UChicago-Space-Program/instrumentation/hasp-balloon/hasp_balloon_code/hasp/hasp_lib/716.jpg

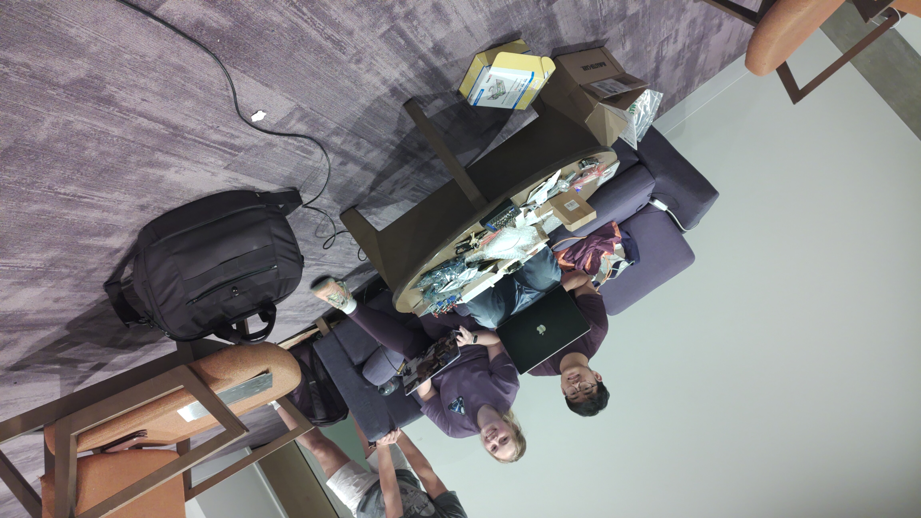
hasp-balloon/hasp_balloon_code/hasp/hasp_lib/716.jpg
