UChicago-Space-Program/instrumentation/hasp-balloon/hasp_balloon_code/hasp/hasp_lib/fast.jpg

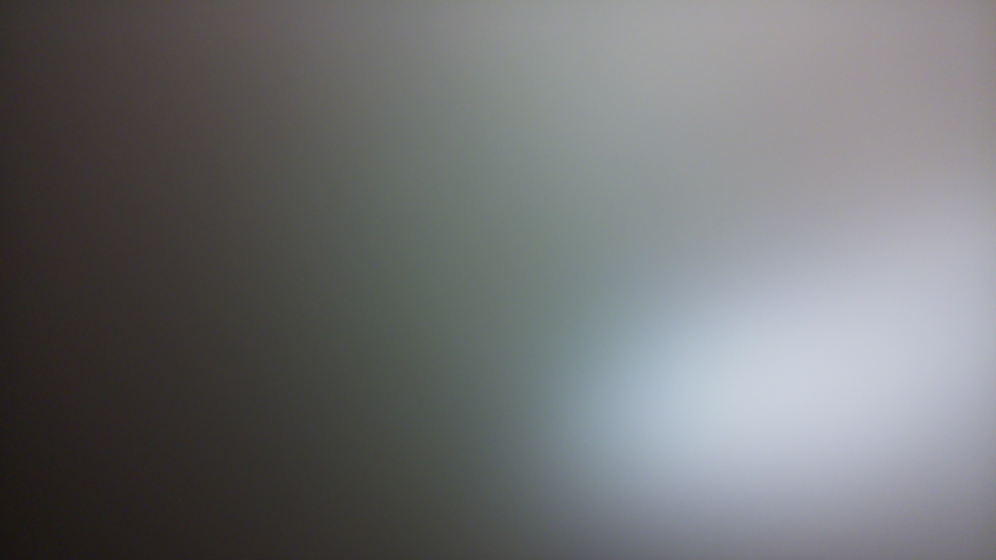
hasp-balloon/hasp_balloon_code/hasp/hasp_lib/fast.jpg
