UChicago-Space-Program/instrumentation/hasp-balloon/hasp_balloon_code/hasp/fast.jpg

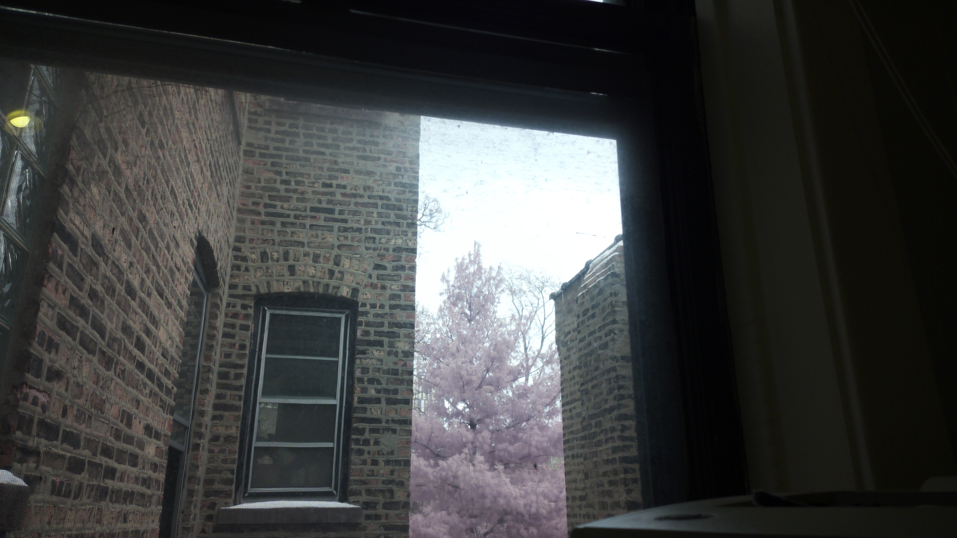
hasp-balloon/hasp_balloon_code/hasp/fast.jpg
