UChicago-Space-Program/instrumentation/hasp-balloon/hasp_balloon_code/hasp/pic0.jpg

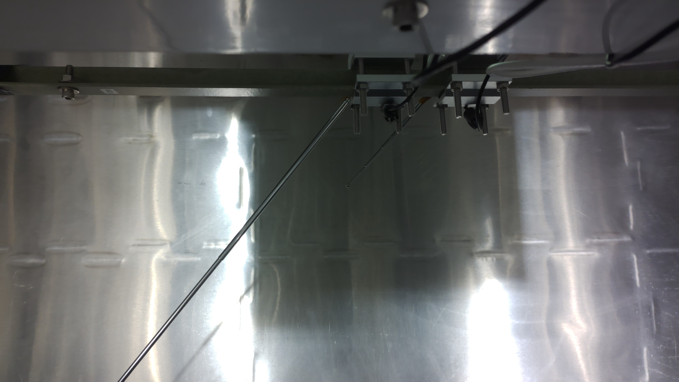
hasp-balloon/hasp_balloon_code/hasp/pic0.jpg
