UChicago-Space-Program/instrumentation/hasp-balloon/hasp_balloon_code/hasp/test1.csv

timestamp | Thermistors | Thermocouple 1 | Thermocouple 2 | RTD | BMP | Pump 1 | Pump 2
2026-04-20 17:02:36.731 | [1.521116960402838, 1.7531517509727625, 2.0367498283360037, 2.410583657587549, 2.5781643396658276, 2.565273517967498, 2.3848020141908903, 2.178548867017624] | 0.0 | 0.0 | -242.02 | hi | 0 | 0
2026-04-20 17:02:38.820 | [2.2301121538109405, 2.410583657587549, 2.5008194094758522, 2.3976928358892193, 2.5394918745708397, 2.5137102311741817, 2.410583657587549, 2.475037766079194] | 0.0 | 0.0 | -242.02 | hi | 0 | 0
2026-04-20 17:02:40.909 | [2.2816754406042574, 2.255893797207599, 2.5266010528725107, 2.436365300984207, 2.6168368047608146, 2.668400091554131, 2.758635843442435, 2.6168368047608146] | 0.0 | 0.0 | -242.02 | hi | 0 | 0
2026-04-20 17:02:42.998 | [2.603945983062485, 2.603945983062485, 2.6168368047608146, 2.655509269855802, 2.758635843442435, 2.668400091554131, 2.7844174868390934, 2.6812909132524605] | 0.0 | 0.0 | -242.02 | hi | 0 | 0
2026-04-20 17:02:45.092 | [2.4492561226825362, 2.655509269855802, 2.745745021744106, 2.6297276264591436, 2.707072556649119, 2.552382696269169, 2.5266010528725107, 2.4492561226825362] | 0.0 | 0.0 | -242.02 | hi | 0 | 0
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
