UChicago-Space-Program/instrumentation/hasp-balloon/electronics/logic/PASCAL_logic_11_4_26.pdf

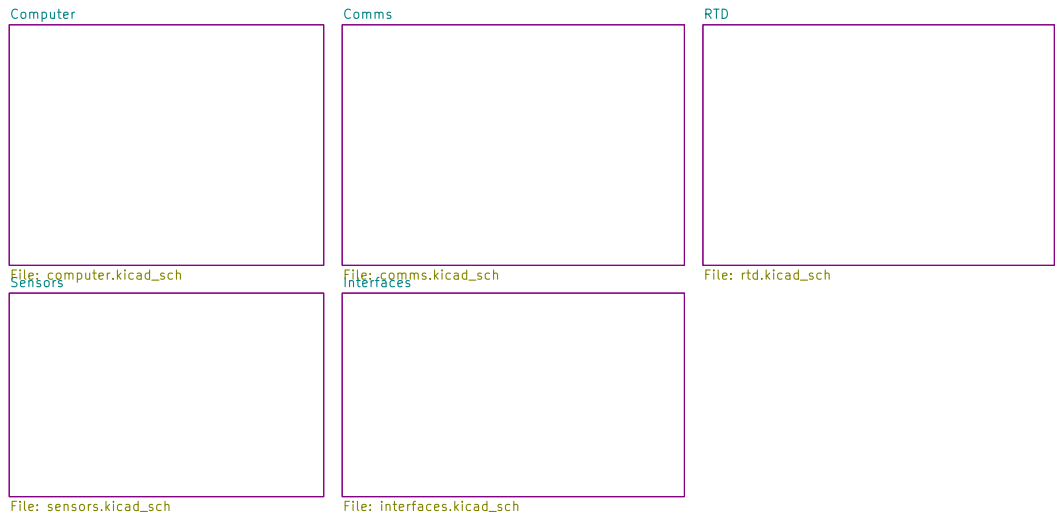
[picture p33: page 1]

Size: A4 | Rev:
KiCad E.D.A. 10.0.8 | Id: 1/6

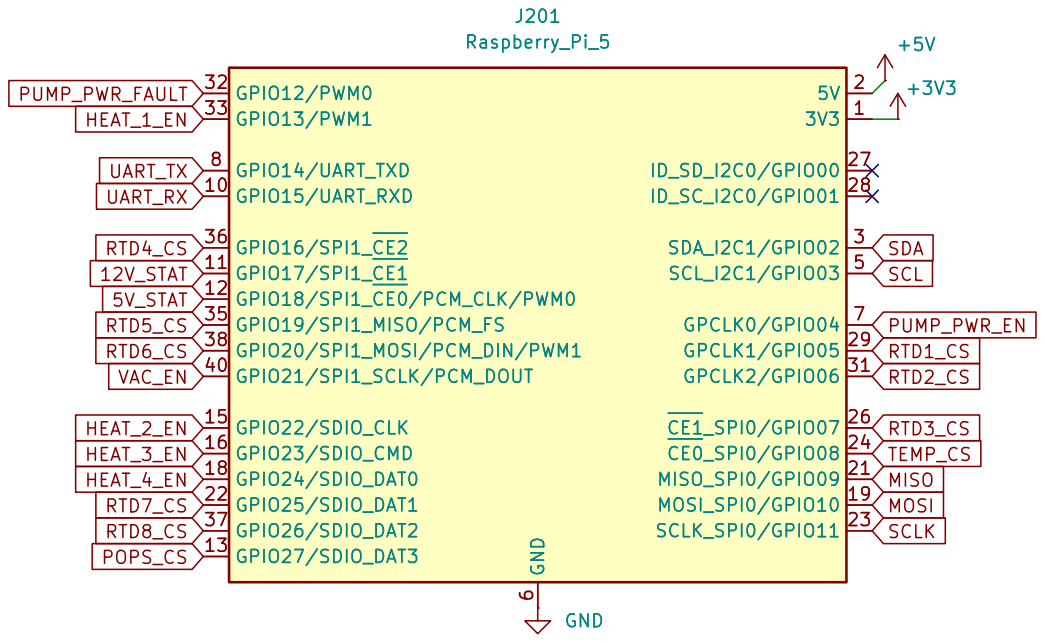
[picture p34: page 2]

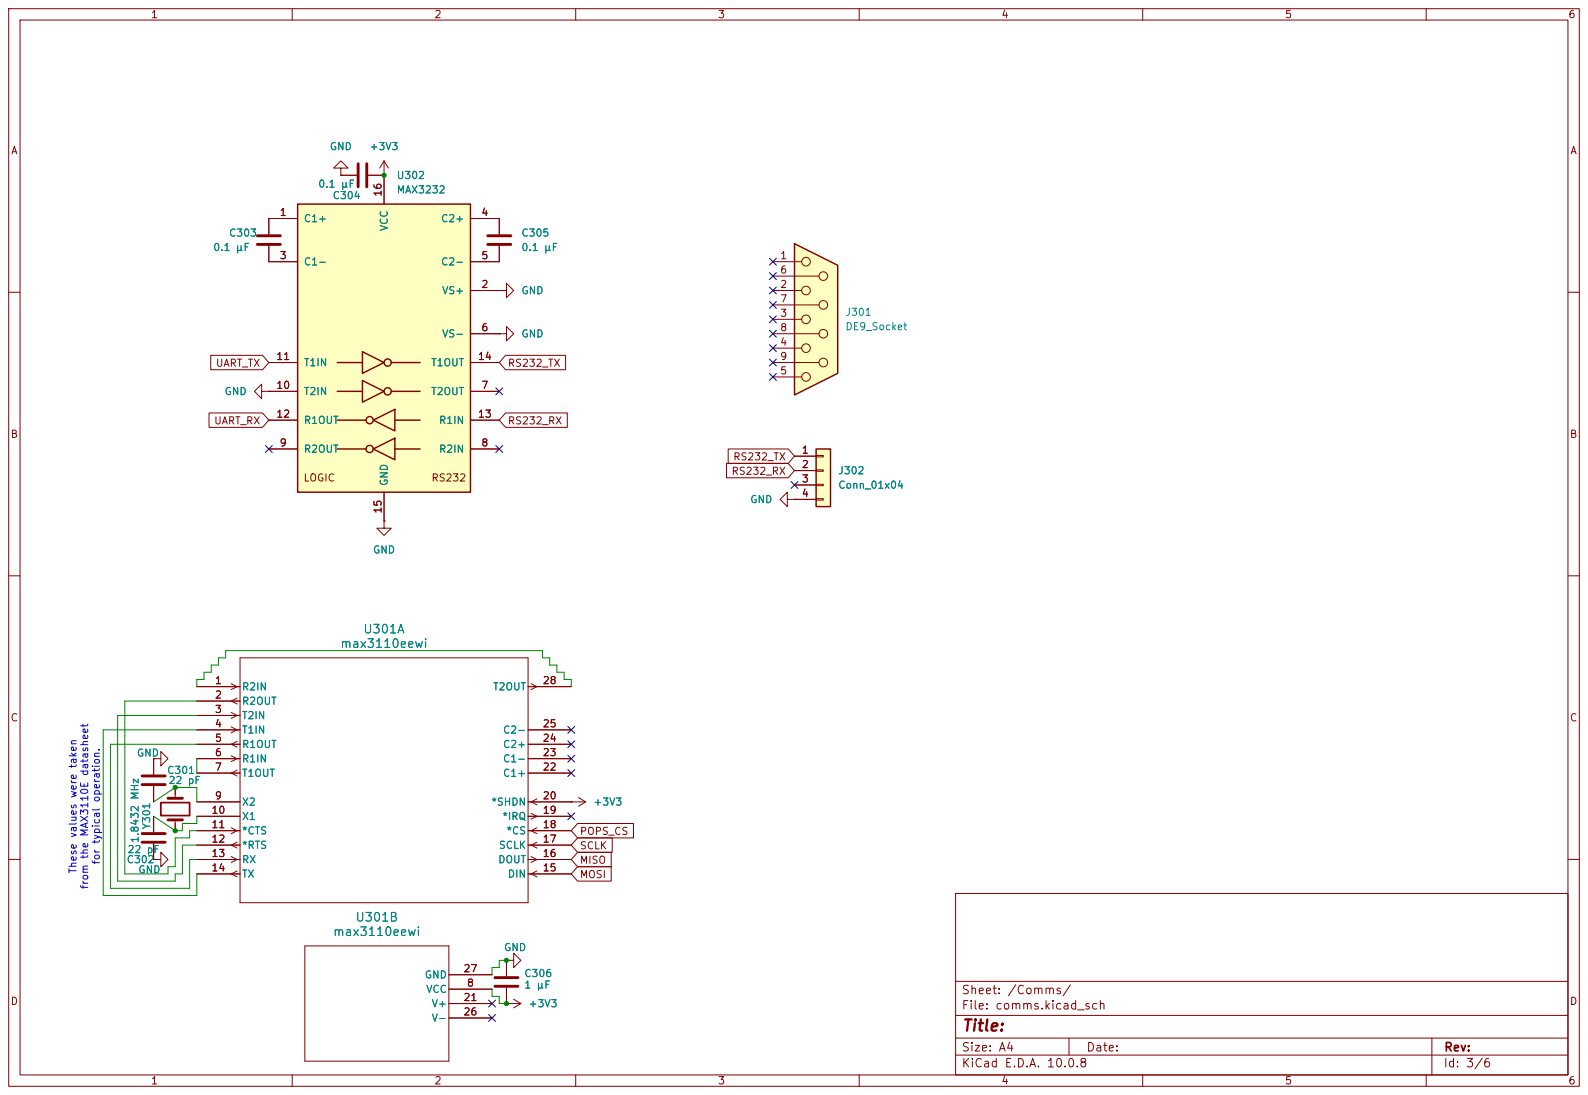
[picture p35: page 3]

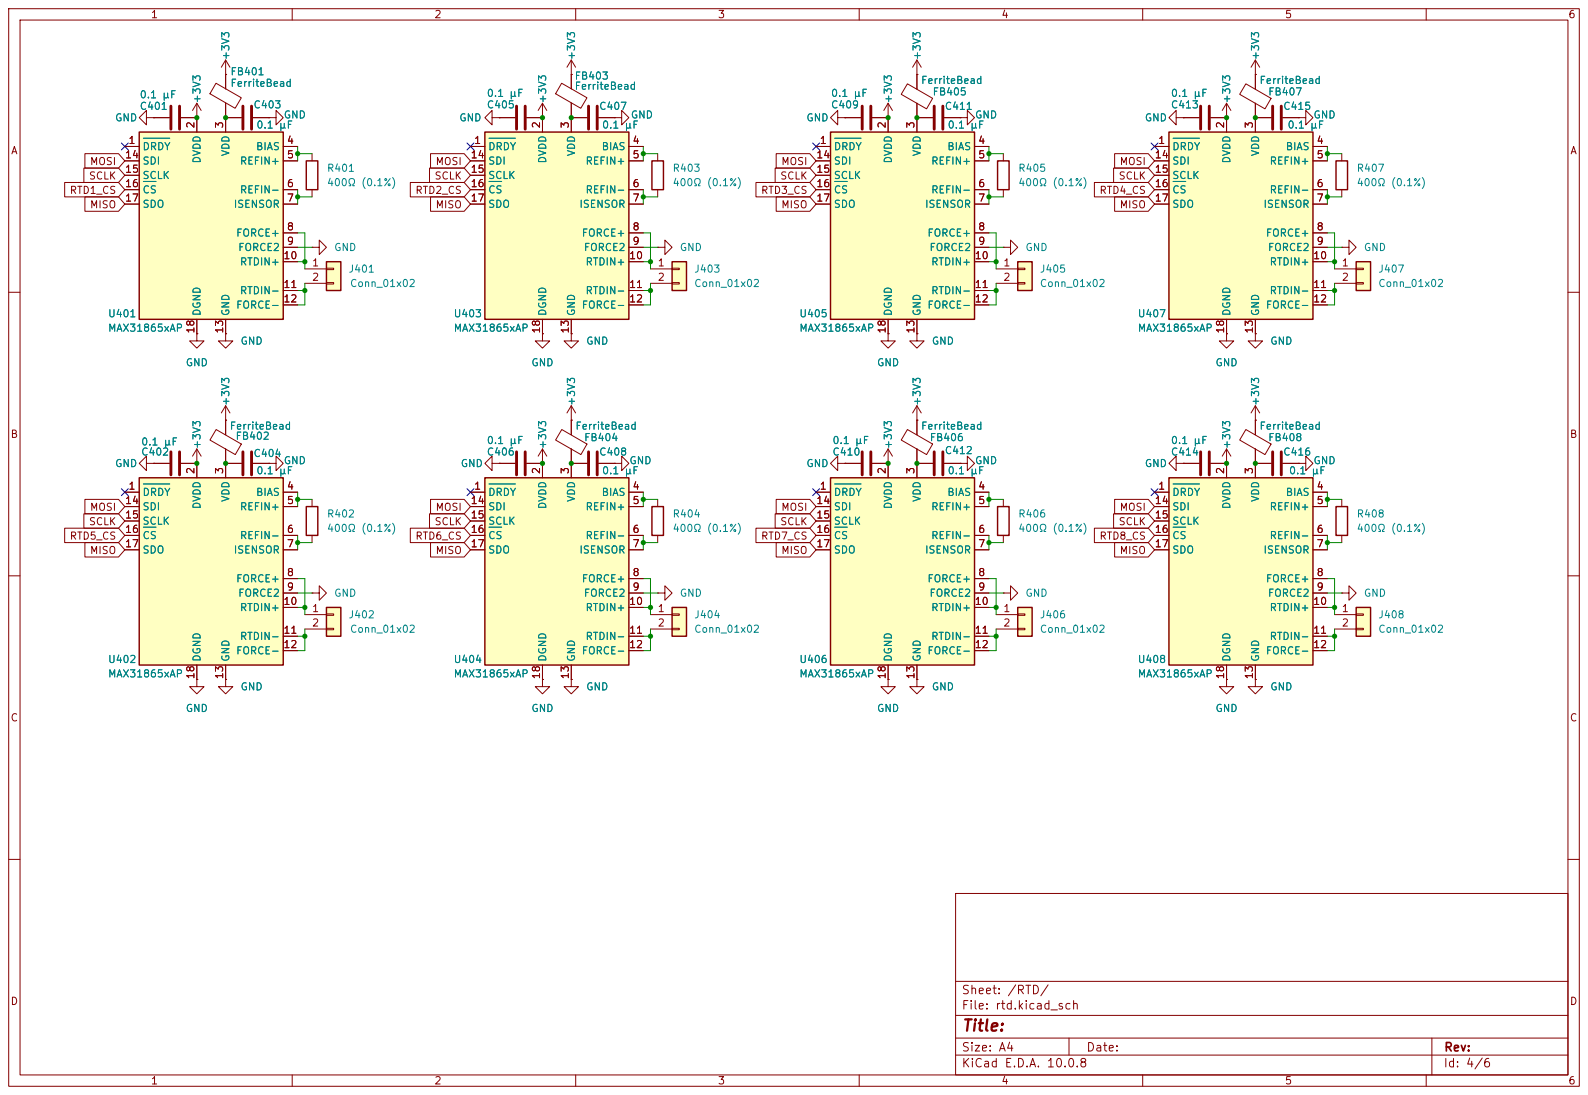
[picture p36: page 4]

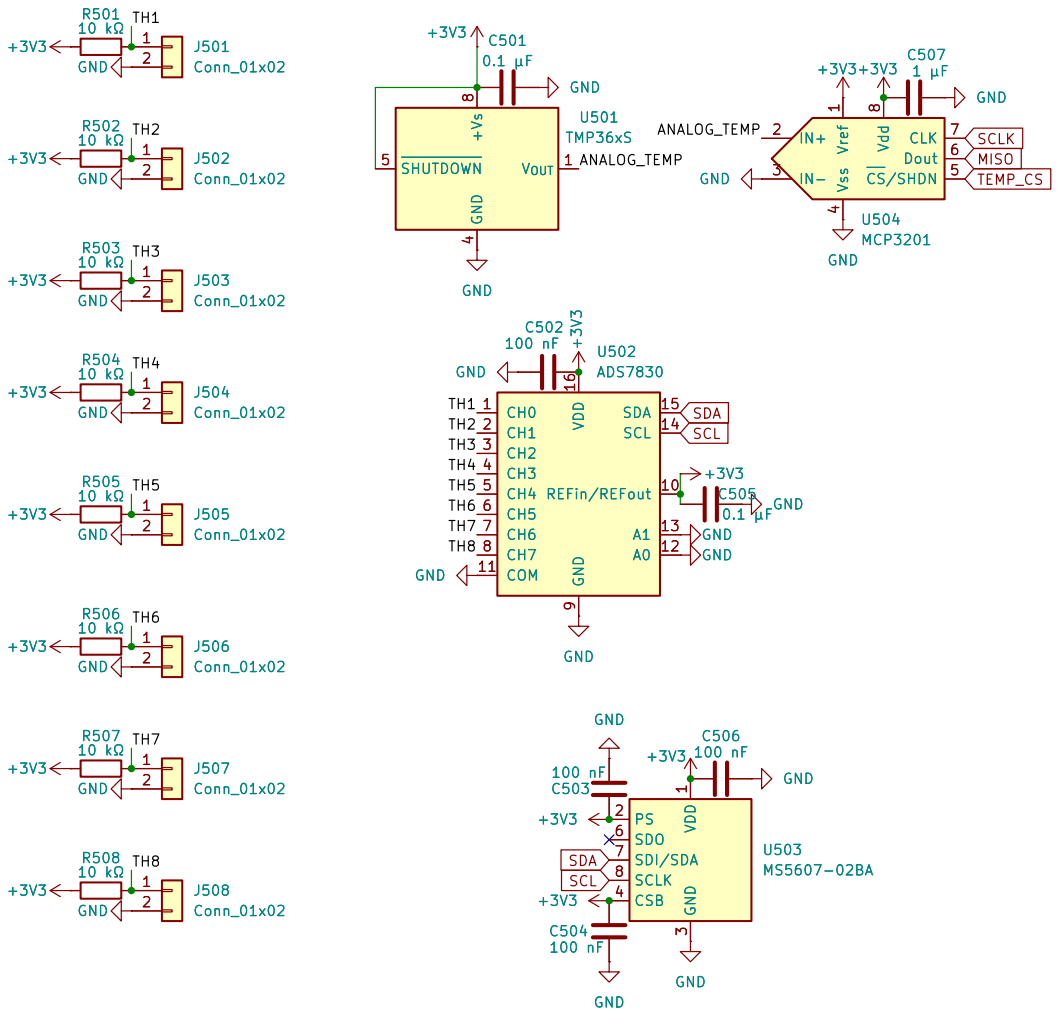
[picture p37: page 5]

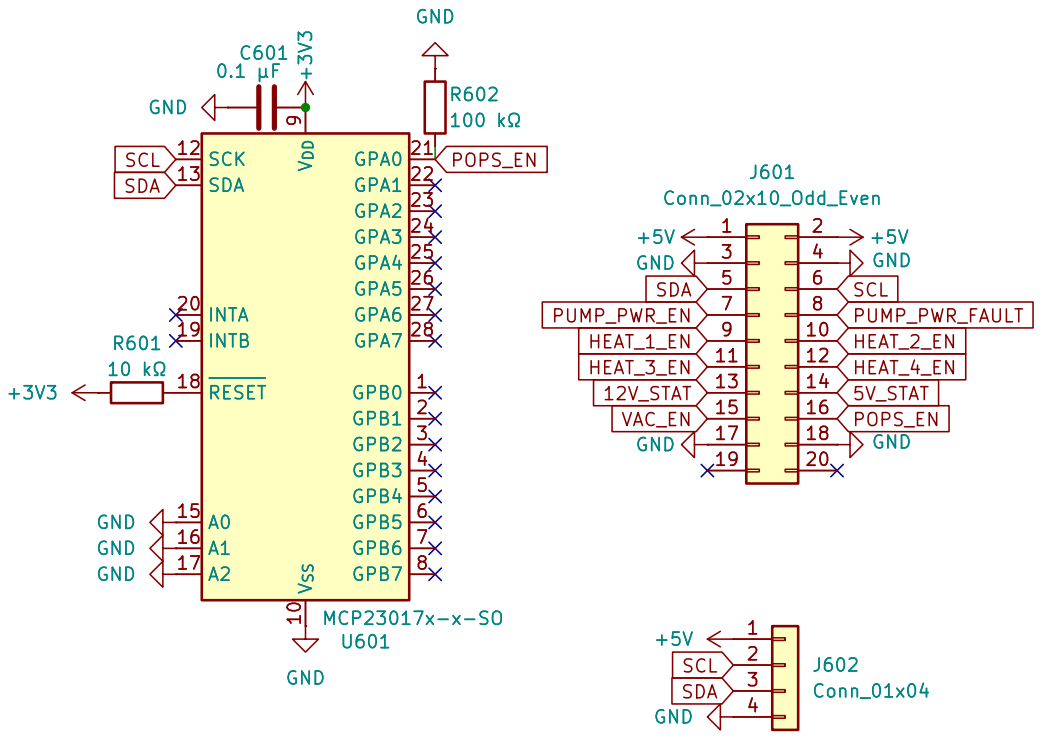
[picture p38: page 6]
