UChicago-Space-Program/instrumentation/hasp-balloon/electronics/power/power.kicad_pcb

## KiCad design hasp-balloon/electronics/power/power.kicad_pcb (2025-11-04)

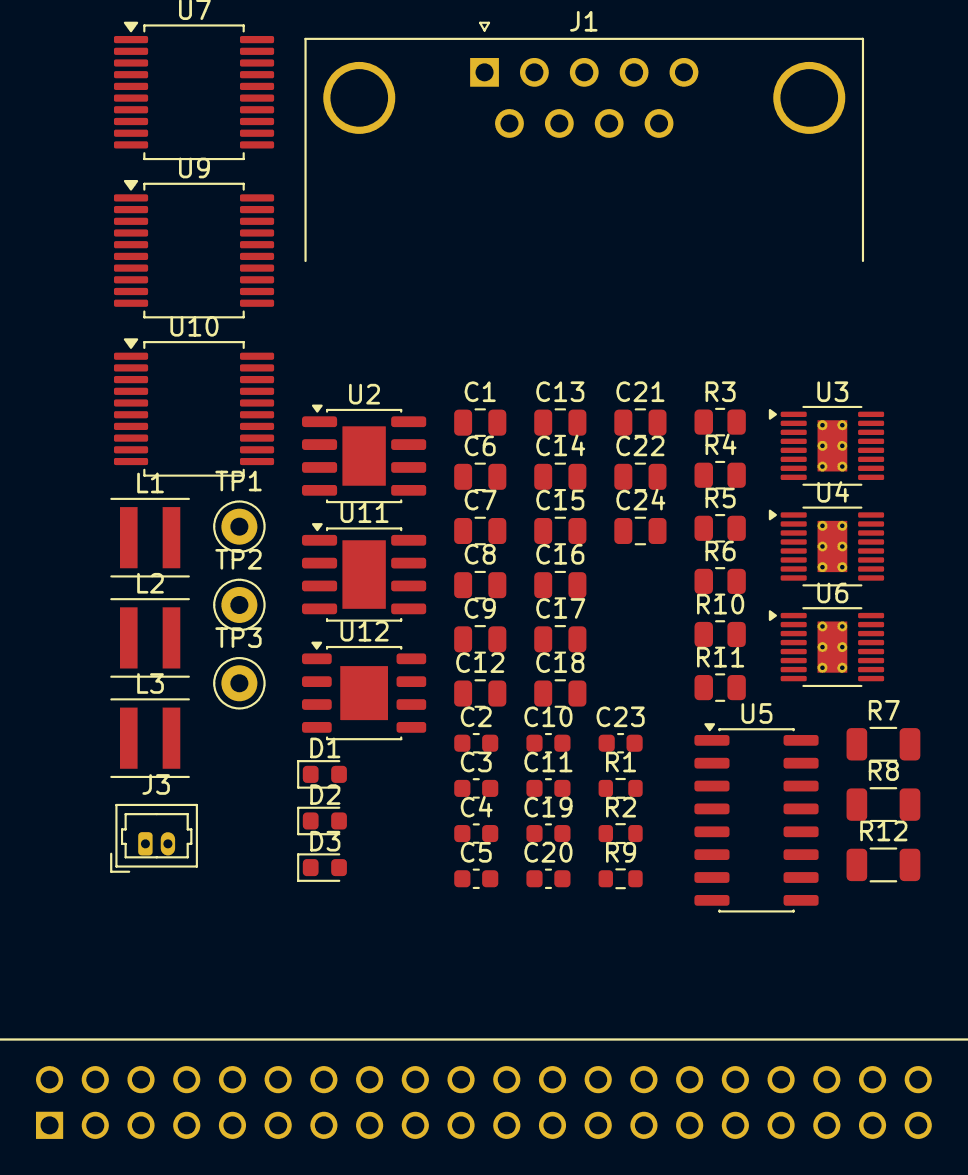
[picture p39: board power.kicad_pcb from above]

Board: 2 copper layers, 58 parts (0 on the bottom side), 44 nets, no tracks yet.

Parts:
C1, C8, C9, C14, C15, C16, C17, C18, C22: 0.1uF; C_0805_2012Metric
C2, C3, C19: 10nF; C_0603_1608Metric
C4, C5, C20: 4.7uF; C_0603_1608Metric
C6, C7, C21: 10pF; C_0805_2012Metric
C10, C11, C23: 1uF; C_0603_1608Metric
C12, C13, C24: 68uF; C_0805_2012Metric
D1, D2, D3: 150060VS75000; LED_0603_1608Metric
J1: DB9; DSUB-9_Pins_Horizontal_P2.77x2.84mm_EdgePinOffset7.70mm_Hou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
J3: Screw Terminal 1x2; Molex_PicoBlade_53047-0210_1x02_P1.25mm_Vertical
L1, L2, L3: 10uH; L_Coilcraft_XxL4040
R1, R2, R9: 110k; R_0603_1608Metric
R3, R4, R10: 243k; R_0805_2012Metric
R5, R6, R11: 1M; R_0805_2012Metric
R7, R8, R12: 150; C_1206_3216Metric
TP1, TP2, TP3: TestPoint_Keystone_5000-5004_Miniature
U1: RASPBERRY_PI_ZERO_2_W; MODULE_RASPBERRY_PI_ZERO_2_W
U2: TMP36FSZ; SOIC-8-1EP_3.9x4.9mm_P1.27mm_EP2.41x3.3mm
U3, U4, U6: LT8610; MSOP-16-1EP_3x4.039mm_P0.5mm_EP1.651x2.845mm_ThermalVias
U5: MAX3232; SOIC-16_3.9x9.9mm_P1.27mm
U7, U9, U10: MAX31865xAP; SSOP-20_5.3x7.2mm_P0.65mm
U11: MCP3201; SOIC-8-1EP_3.9x4.9mm_P1.27mm_EP2.41x3.81mm
U12: BSP742T; Infineon_PG-DSO-8-27_3.9x4.9mm_EP2.65x3mm

Connections:
3V3: C1.2, C14.2, U1.1 (3V3_1), U1.17 (3V3_17), U2.5 (SHUTDOWN), U2.8 (V_IN), U5.16 (VCC)
5V: C6.2, C12.2, D1.2 (A), L1.2, R5.2, TP1.1, U1.2 (5V_2), U1.4 (5V_4), U3.14 (BIAS)
5V_STAT: U3.15 (PG), U4.15 (PG), U6.15 (PG)
6V: C7.2, C13.2, D2.2 (A), L2.2, R6.2, TP2.1, U4.14 (BIAS)
12V: C21.2, C24.2, D3.2 (A), L3.2, R11.2, TP3.1, U6.14 (BIAS), U12.5 (Vbb), U12.6 (Vbb), U12.7 (Vbb), U12.8 (Vbb)
28V: C4.1, U3.4 (EN/UV), U3.5 (VIN), U3.6 (VIN)
/FB_3: C6.1, C7.1, C21.1, R3.2, R4.2, R5.1, R6.1, R10.2, R11.1, U3.16 (FB), U4.16 (FB), U6.16 (FB)
/MISO: U1.21 (GPIO9/SPI_MISO), U7.17 (SDO), U9.17 (SDO), U10.17 (SDO)
/MOSI: U1.19 (GPIO10/SPI_MOSI), U7.14 (SDI), U9.14 (SDI), U10.14 (SDI)
/RS232_RX: J1.3, U5.13 (R1IN)
/RS232_TX: J1.2, U5.14 (T1OUT)
/SCLK: U1.23 (GPIO11/SPI_SCLK), U7.15 (SCLK), U9.15 (SCLK), U10.15 (SCLK)
/SW_3: C8.2, C9.2, C22.2, L1.1, L2.1, L3.1, U3.9 (SW), U3.10 (SW), U3.11 (SW), U4.9 (SW), U4.10 (SW), U4.11 (SW), U6.9 (SW), U6.10 (SW), U6.11 (SW)
/UART_RX: U1.10 (GPIO15/RXD0), U5.12 (R1OUT)
/UART_TX: U1.8 (GPIO14/TXD0), U5.11 (T1IN)
/VAC_EN: U1.40 (GPIO21), U12.2 (IN)
GND: C1.1, C2.1, C3.1, C4.2, C5.2, C10.2, C11.2, C12.1, C13.1, C14.1, C17.1, C18.1, C19.1, C20.2, C23.2, C24.1, J1.5, J3.2, R1.2, R2.2, R3.1, R4.1, R7.1, R8.1, R9.2, R10.1, R12.1, U1.6 (GND_6), U1.9 (GND_9), U1.14 (GND_14), U1.20 (GND_20), U1.25 (GND_25), U1.30 (GND_30), U1.34 (GND_34), U1.39 (GND_39), U2.4 (GND), U3.7 (GND), U3.8 (GND), U3.17 (GND), U4.7 (GND), U4.8 (GND), U4.17 (GND), U5.15 (GND), U6.7 (GND), U6.8 (GND), U6.17 (GND), U11.3 (IN-), U12.1 (GND)
unnamed: D1.1 (K), R7.2
unnamed: D2.1 (K), R8.2
unnamed: D3.1 (K), R12.2
unnamed: J3.1, U12.3 (OUT)
unnamed: C8.1, U3.12 (BST)
unnamed: C10.1, U3.13 (INTVcc)
unnamed: R1.1, U3.3 (RT)
unnamed: C2.2, U3.2 (TR/SS)
unnamed: C9.1, U4.12 (BST)
unnamed: C11.1, U4.13 (INTVcc)
unnamed: R2.1, U4.3 (RT)
unnamed: C3.2, U4.2 (TR/SS)
unnamed: C15.2, U5.1 (C1+)
unnamed: C15.1, U5.3 (C1-)
unnamed: C16.1, U5.4 (C2+)
unnamed: C16.2, U5.5 (C2-)
unnamed: C17.2, U5.2 (VS+)
unnamed: C18.2, U5.6 (VS-)
unnamed: C22.1, U6.12 (BST)
unnamed: C23.1, U6.13 (INTVcc)
unnamed: R9.1, U6.3 (RT)
unnamed: C19.2, U6.2 (TR/SS)
unnamed: U7.13 (GND), U7.19 (GND)
unnamed: U9.13 (GND), U9.19 (GND)
unnamed: U10.13 (GND), U10.19 (GND)
unnamed: U2.1 (V_OUT), U11.2 (IN+)
VBATT: C5.1, C20.1, U4.4 (EN/UV), U4.5 (VIN), U4.6 (VIN), U6.4 (EN/UV), U6.5 (VIN), U6.6 (VIN)
