UChicago-Space-Program/instrumentation/(commit log)

2025-11-01 feat: power board
    [power.kicad_pcb, power.kicad_sch]
2025-11-04 feat: schematic v1
    [power.kicad_pcb, power.kicad_sch]
2026-05-23 feat: scripts for sensors
2026-11-05 PASCAL 2027 logic board schematic (draft)
2026-11-05 feat: logic board split into sheets with global labels; MAX3110E library
2026-11-08 feat: made descriptions, schematics, diagrams more readable
2026-11-08 logic: drop MAX3110E, POPS on RS232 Pal channel 2 (Pi UART2), BMP388 replaces BMP280
